Abd-El-Rhman-Saad/Autonomous-Sorting-Robotic-Arm/images/Lab_01_Hardware_Prototype.jpg

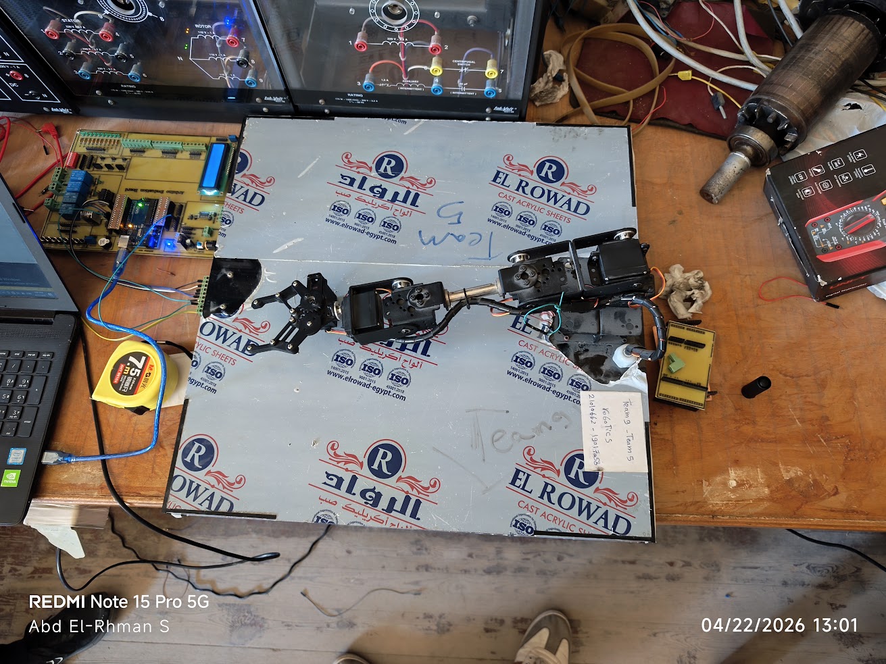
images/Lab_01_Hardware_Prototype.jpg
