Abd-El-Rhman-Saad/Autonomous-Sorting-Robotic-Arm/images/System_03_Conveyor_Design.png

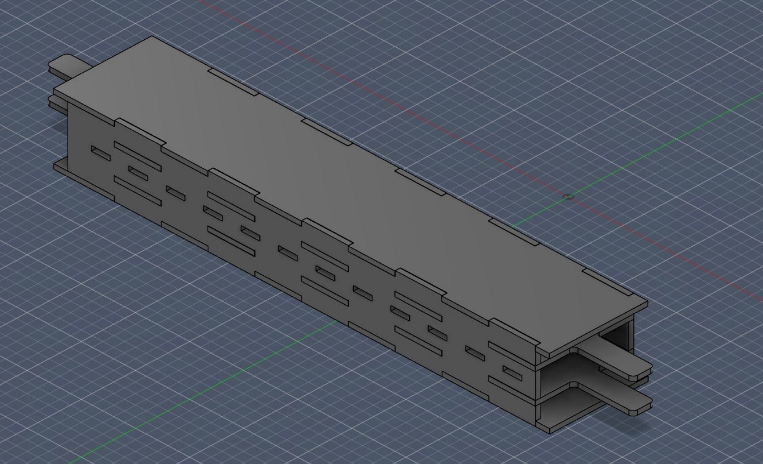
images/System_03_Conveyor_Design.png
